koi-science/DI-Lambda-schematics-avr/DI-Lambda-UNO/DI-Lambda-UNO-panel-LED/DI-Lambda-UNO-panel-LED.kicad_pcb

## KiCad design DI-Lambda-UNO/DI-Lambda-UNO-panel-LED/DI-Lambda-UNO-panel-LED.kicad_pcb (2019-07-14)

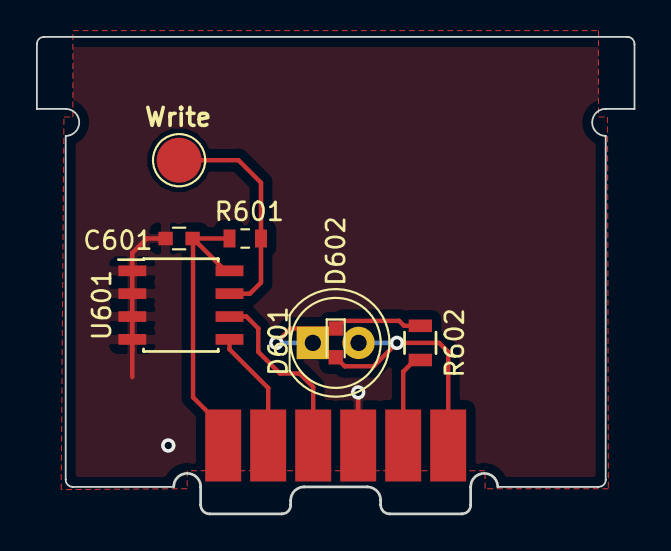
[picture p1: board DI-Lambda-UNO-panel-LED.kicad_pcb from above]

Board: 2 copper layers, 33.2 x 26.5 mm, 9 parts (0 on the bottom side), 8 nets.

Parts:
C601: 0.1uF 25v; C_0603
D601: LED; LED_D5.0mm
D602: LED; LED_0603
J601: Conn_01X06; Contact-2.5x6
MK601: Mounting_Hole; Tab_LED
R601: 4.75K; R_0603_1608Metric
R602: 470R; R_0805
U601: 24LC02; SOIC-8_3.9x4.9mm_Pitch1.27mm
W601: WRITE; TestPoint_Pad_D2.5mm

Connections:
/GLED: J601.5, R602.1
/SCL: J601.3, U601.6
/SDA: J601.2, U601.5
/VCC: C601.1, J601.1, R601.1, U601.8
/VLED: D601.2, D602.2, J601.6
GND: C601.2, J601.4, U601.1, U601.2, U601.3, U601.4
unnamed: D601.1, D602.1, R602.2
unnamed: R601.2, U601.7, W601.1
