koi-science/DI-Lambda-schematics-avr/DI-Lambda-UNO/DI-Lambda-UNO-bottom/DI-Lambda-UNO-bottom.kicad_pcb

## KiCad design DI-Lambda-UNO/DI-Lambda-UNO-bottom/DI-Lambda-UNO-bottom.kicad_pcb (2019-07-14)

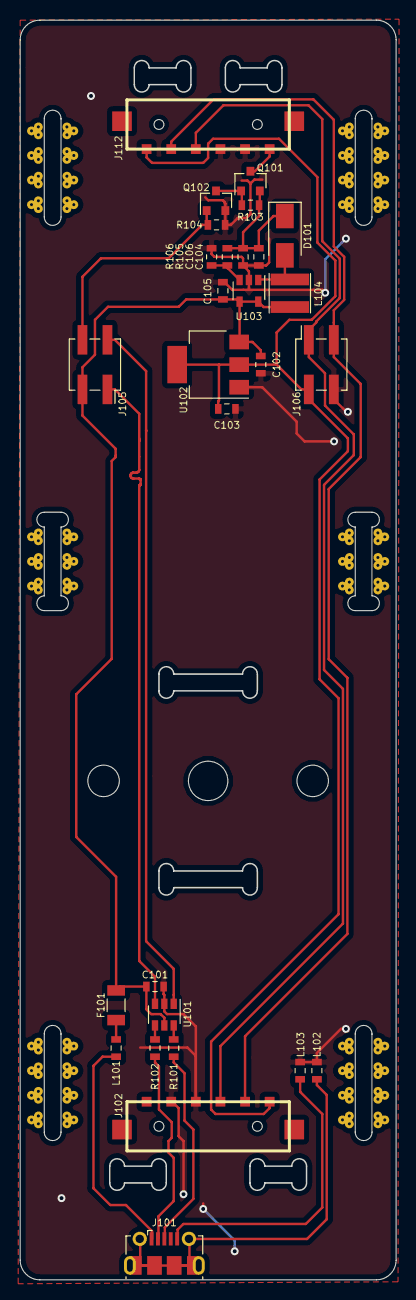
[picture p2: board DI-Lambda-UNO-bottom.kicad_pcb from above]

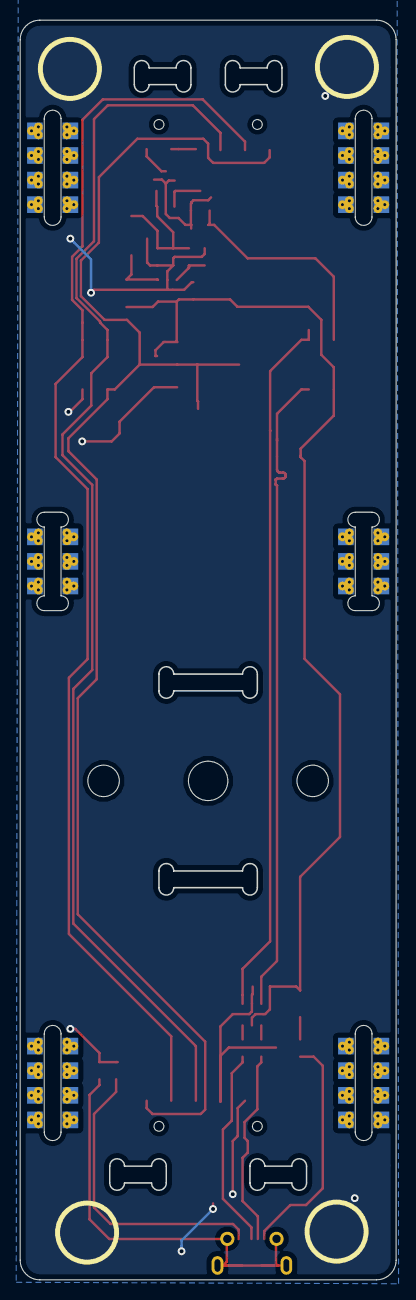
[picture p3: board DI-Lambda-UNO-bottom.kicad_pcb from below]

Board: 2 copper layers, 38.2 x 128.0 mm, 39 parts (6 on the bottom side), 21 nets.

Parts:
C101, C102, C103, C105: 4.7uF 6.3v; C_0603_1608Metric
C104, C106: 1uF 16v; C_0603_1608Metric
D101: SS14; D_SMA
F101: 0.2A; Fuse_1206_3216Metric
J101: USB_OTG; USB_Micro-B_Molex-105017-0001
J102, J112: CONN_01X06; Spring-contact-connector-2.5x6
J103, J104, J110, J111: Conn_02x04_Odd_Even; Pocket_1.6mm_10mm_no_cap_8pads_short_vias
J105, J106: Conn_02x02_Odd_Even; PinSocket_2x02_P2.54mm_Vertical_SMD
J107: Conn_01x01; Cuvette-holder
J108, J109: Conn_02x03_Odd_Even; Pocket_1.6mm_10mm_2cap_6pads_short_vias
L101, L102, L103: FB; L_0603_1608Metric
L104: 6.8uH; L_Taiyo-Yuden_NR-40xx
MK101: Mounting_Hole; Slot_LED
MK102, MK103: Mounting_Hole; Slot_pinhole
MK104: Mounting_Hole; Slot_sensor
Q101: AO3401; SOT-23
Q102: AO3400; SOT-23
R101, R102: 22R; R_0603_1608Metric
R103, R104, R106: 4.75k; R_0603_1608Metric
R105: 42.2k; R_0603_1608Metric
U101: USBLC6-2SC6; SOT-23-6
U102: 3.3v LDO; SOT-223-3_TabPin2
U103: AP3015; SOT-23-5

Connections:
/12v: C104.1, C106.1, D101.1, Q101.2, R103.1, R105.1
/DI_N: J101.2, R102.2
/DI_P: J101.3, R101.2
/D_N: J105.1, U101.3
/D_P: J105.2, U101.1
/LED_PWM: J105.4, Q102.1, R104.1
/SCL: J102.3, J106.1, J112.3
/SDA: J102.2, J106.3, J112.2
/SW: D101.2, L104.1, U103.1
/VBUS: C101.1, C102.2, C105.2, F101.1, J105.3, L104.2, U101.5, U102.3, U103.4, U103.5
/VCC: C103.2, J102.1, J106.2, J112.1, U102.2
/VLED: J112.6, Q101.3
/_D_N: R102.1, U101.4
/_D_P: R101.1, U101.6
GND: C101.2, C102.1, C103.1, C104.2, C105.1, C106.2, J102.4, J102.5, J106.4, J112.4, J112.5, L102.2, L103.2, Q102.2, R104.2, R106.2, U101.2, U102.1, U103.2
unnamed: F101.2, L101.1
unnamed: J101.1, L101.2
unnamed: J101.5, L103.1
unnamed: J101.6, L102.1
unnamed: Q101.1, Q102.3, R103.2
unnamed: R105.2, R106.1, U103.3
