koi-science/DI-Lambda-schematics-avr/DI-Lambda-UNO/DI-Lambda-UNO-panel-Photodiode/DI-Lambda-UNO-panel-Photodiode.kicad_pcb

## KiCad design DI-Lambda-UNO/DI-Lambda-UNO-panel-Photodiode/DI-Lambda-UNO-panel-Photodiode.kicad_pcb (2019-07-14)

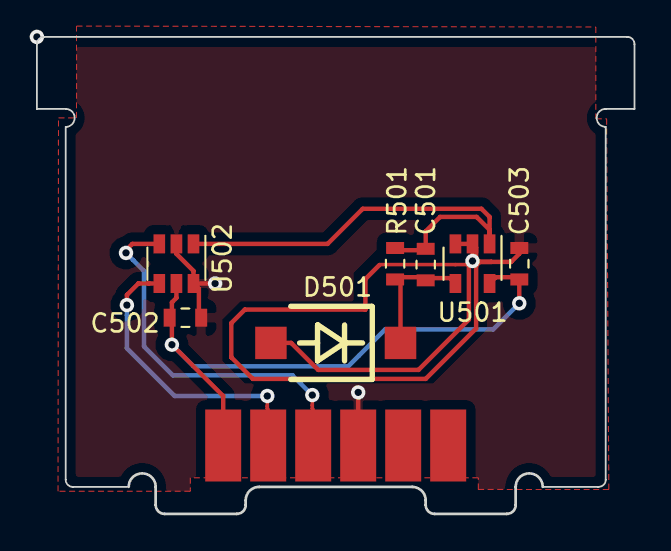
[picture p4: board DI-Lambda-UNO-panel-Photodiode.kicad_pcb from above]

Board: 2 copper layers, 33.2 x 26.5 mm, 9 parts (0 on the bottom side), 6 nets.

Parts:
C501: 10pf; C_0603_1608Metric
C502, C503: 0.1uF 25v; C_0603_1608Metric
D501: D_Photo; 2-SMD-Everlight-Photodiode
J501: Conn_01X06; Contact-2.5x6
MK501: Mounting_Hole; Tab_SENSOR
R501: 1M; R_0603_1608Metric
U501: TP1271; SOT-23-5
U502: MCP3421A0T-E/CH; SOT-23-6

Connections:
/SCL: J501.3, U502.3
/SDA: J501.2, U502.4
/VCC: C502.1, C503.1, J501.1, U501.5, U502.5
GND: C502.2, C503.2, D501.2, J501.4, U501.2, U501.3, U502.2, U502.6
unnamed: C501.1, R501.1, U501.1, U502.1
unnamed: C501.2, D501.1, R501.2, U501.4
