koi-science/DI-Lambda-schematics-avr/DI-Lambda-UNO/DI-Lambda-UNO-top/DI-Lambda-UNO-top.kicad_pcb

## KiCad design DI-Lambda-UNO/DI-Lambda-UNO-top/DI-Lambda-UNO-top.kicad_pcb (2019-07-14)

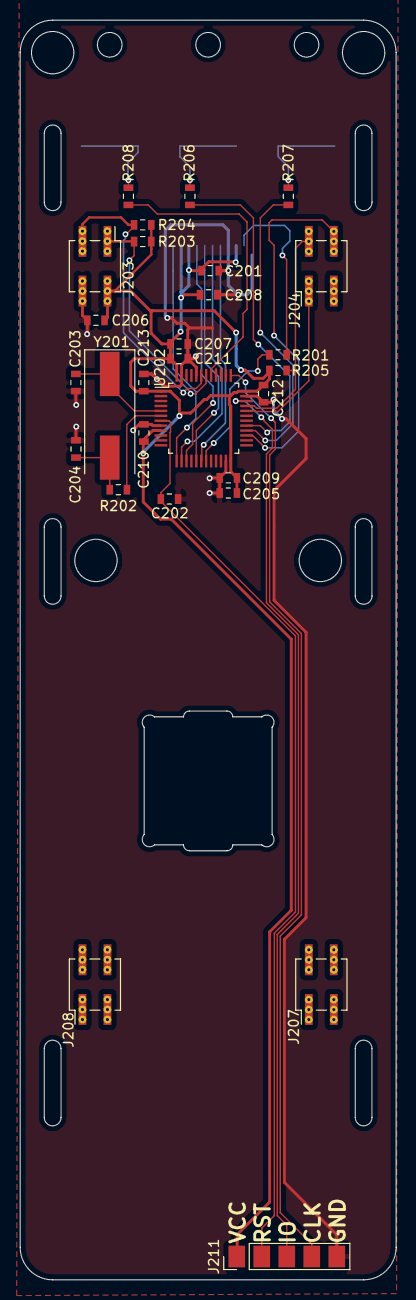
[picture p5: board DI-Lambda-UNO-top.kicad_pcb from above]

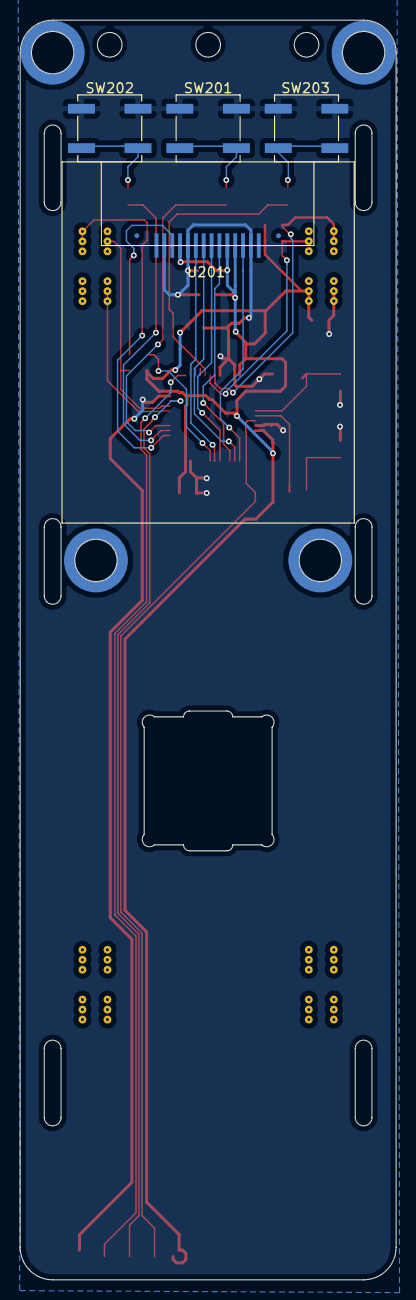
[picture p6: board DI-Lambda-UNO-top.kicad_pcb from below]

Board: 2 copper layers, 38.2 x 128.0 mm, 44 parts (14 on the bottom side), 26 nets.

Parts:
C201, C205, C206, C207: 4.7uF 6.3v; C_0603_1608Metric
C202, C208, C209, C210, C211, C212, C213: 0.1uF 25v; C_0603_1608Metric
C203, C204: 10pF 25V; C_0603_1608Metric
J201, J202, J209, J210: Conn_02x04_Odd_Even; Pocket_1.6mm_7mm_no_cap
J203, J204, J207, J208: Conn_02x02_Odd_Even; PinHeader_2x02_P2.54mm_Vertical_SMD_vias
J205, J206: Conn_02x03_Odd_Even; Pocket_1.6mm_7mm_no_cap
J211: Conn_01x05; Testpoint_1x05_P2.54mm_mixed
MK201: Mounting_Hole; Button_mounts_x3
MK202, MK203, MK204, MK205: Mounting_Hole; Mounting-Hole-SMT-nut-M3-4.3mm
MK206: Mounting_Hole; Cuvette-cutout-top
R201: 220R; R_0603_1608Metric
R202: 390R; R_0603_1608Metric
R203, R204: 4.75K; R_0603_1608Metric
R205, R206, R207, R208: 1.5K; R_0603_1608Metric
SW201: SW_SAMPLE; SW_SPST_B3SL-1002P
SW202: SW_MODE; SW_SPST_B3SL-1002P
SW203: SW_BLANK; SW_SPST_B3SL-1002P
U201: LCD_1.44_ST7735
U202: STM32F103C8Tx; LQFP-48_7x7mm_P0.5mm
Y201: 8Mhz; Crystal_SMD_HC49-SD

Connections:
/BLANK: R208.2, U202.41
/DN: J204.1, U202.32
/DP: J204.2, R205.2, U202.33
/LCD_A0: U201.7, U202.14
/LCD_CS: U201.12, U202.13
/LCD_LED: R201.2, U202.19
/LCD_RST: U201.6, U202.18
/LED_PWM: J204.4, U202.27
/MODE: R207.2, U202.28
/MOSI: U201.8, U202.17
/SAMPLE: R206.2, U202.29
/SCK: U201.9, U202.15
/SCL: J203.1, R203.2, U202.42
/SDA: J203.3, R204.1, U202.43
/SWDCLK: J211.4, U202.37
/SWDIO: J211.3, U202.34
/VCC: C201.2, C205.2, C206.2, C207.2, C208.1, C209.1, C210.1, C211.1, C212.1, C213.1, J203.2, J211.1, R203.1, R204.2, R205.1, U201.4, U201.10, U201.11, U202.1, U202.9, U202.24, U202.36, U202.48
/nRST: C202.1, J211.2, U202.7
GND: C201.1, C202.2, C203.2, C204.2, C205.1, C206.1, C207.1, C208.2, C209.2, C210.2, C211.2, C212.2, C213.2, J203.4, J211.5, SW201.2, SW202.2, SW203.2, U201.2, U201.5, U201.13, U202.8, U202.23, U202.35, U202.44, U202.47
unnamed: C203.1, U202.5, Y201.1
unnamed: C204.1, R202.2, Y201.2
unnamed: R201.1, U201.3
unnamed: R202.1, U202.6
unnamed: R206.1, SW201.1
unnamed: R207.1, SW202.1
unnamed: R208.1, SW203.1
