koi-science/DI-Lambda-schematics-avr/DI-Lambda-UNO/DI-Lambda-UNO-side/DI-Lambda-UNO-side.kicad_pcb

## KiCad design DI-Lambda-UNO/DI-Lambda-UNO-side/DI-Lambda-UNO-side.kicad_pcb (2019-07-14)

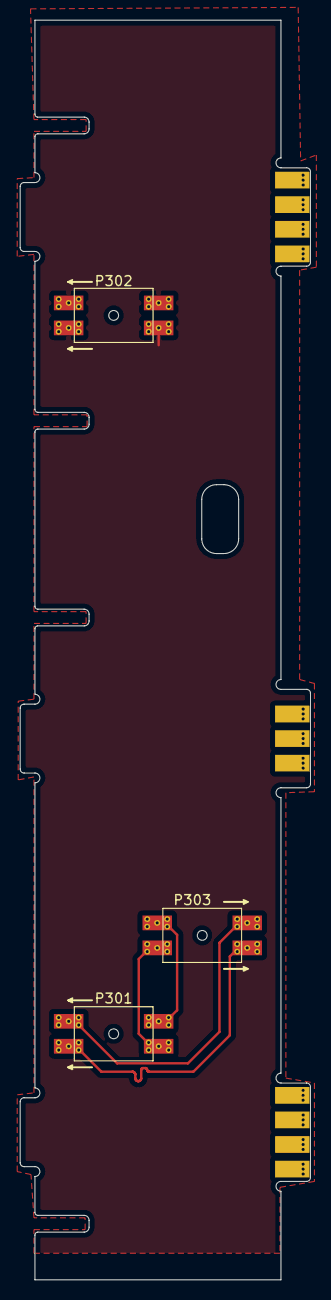
[picture p7: board DI-Lambda-UNO-side.kicad_pcb from above]

Board: 2 copper layers, 29.5 x 128.0 mm, 10 parts (0 on the bottom side), 5 nets.

Parts:
MK301, MK302, MK303: Mounting_Hole; Tab_7mm_1.5mm
MK304: Mounting_Hole; Cuvette_holder_side_hole
P301, P302, P303: CONN_02X02; Female_socket_2.54_2x2p_horizontal_smt
P304, P306: CONN_01X04; Tab_10mm_4pads_vias_3mm
P305: CONN_01X04; Tab_10mm_3pads_vias_3mm

Connections:
/A+: P301.1, P303.3
/A-: P301.3, P303.1
/B+: P301.4, P303.2
/B-: P301.2, P303.4
GND: P302.1, P302.2, P302.3, P302.4
