koi-science/DI-Lambda-schematics-avr/DI-Lambda-UNO/DI-Lambda-UNO-panel-TSL2561/DI-Lambda-UNO-panel-TSL2561.kicad_pcb

## KiCad design DI-Lambda-UNO/DI-Lambda-UNO-panel-TSL2561/DI-Lambda-UNO-panel-TSL2561.kicad_pcb (2017-11-26)

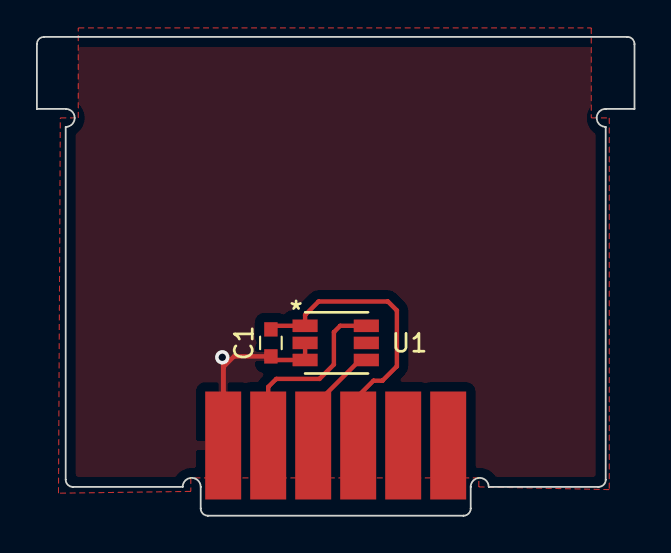
[picture p8: board DI-Lambda-UNO-panel-TSL2561.kicad_pcb from above]

Board: 2 copper layers, 33.2 x 26.6 mm, 3 parts (0 on the bottom side), 4 nets.

Parts:
C1: C_Small; C_0603
J1: Conn_01X06; Contact-2.5x6
U1: TSL2561; TMB-6

Connections:
/SCL: J1.3, U1.4
/SDA: J1.2, U1.6
/VCC: C1.1, J1.4, U1.1
GND: C1.2, J1.1, U1.2, U1.3
