koi-science/DI-Lambda-schematics-avr/DI-Lambda-DITOS/ditos-TSL2561/ditos-TSL2561.kicad_pcb

## KiCad design DI-Lambda-DITOS/ditos-TSL2561/ditos-TSL2561.kicad_pcb (2017-08-27)

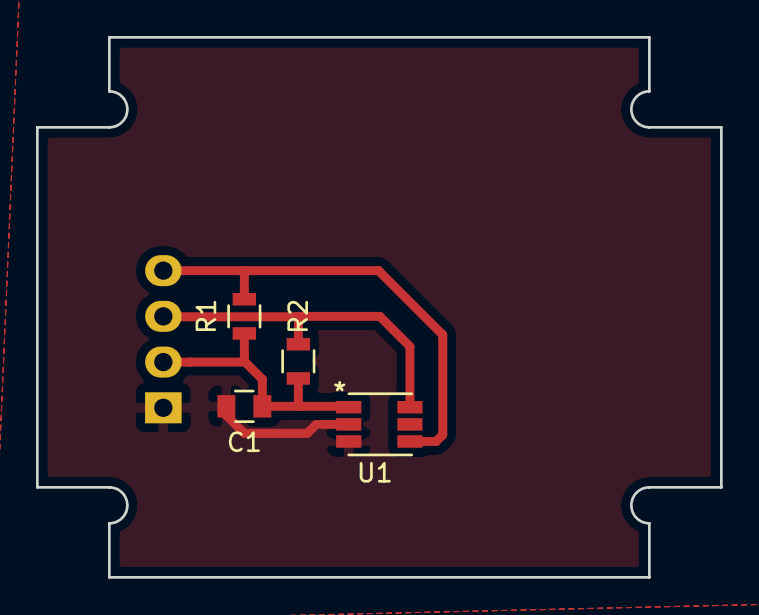
[picture p9: board ditos-TSL2561.kicad_pcb from above]

Board: 2 copper layers, 38.0 x 30.0 mm, 5 parts (1 on the bottom side), 4 nets.

Parts:
C1: 1uF; C_0805
P1: CONN_01X04; Pin_Header_Straight_1x04
R1, R2: 4K7; R_0805
U1: TSL2561; TMB-6

Connections:
GND: C1.1, P1.1, U1.2, U1.3
unnamed: P1.3, R2.1, U1.6
unnamed: P1.4, R1.2, U1.4
VCC: C1.2, P1.2, R1.1, R2.2, U1.1
