koi-science/DI-Lambda-schematics-avr/DI-Lambda-DITOS/DI-Lambda-DITOS-controller/DI-Lambda-DITOS-controller.kicad_pcb

## KiCad design DI-Lambda-DITOS/DI-Lambda-DITOS-controller/DI-Lambda-DITOS-controller.kicad_pcb (2017-08-27)

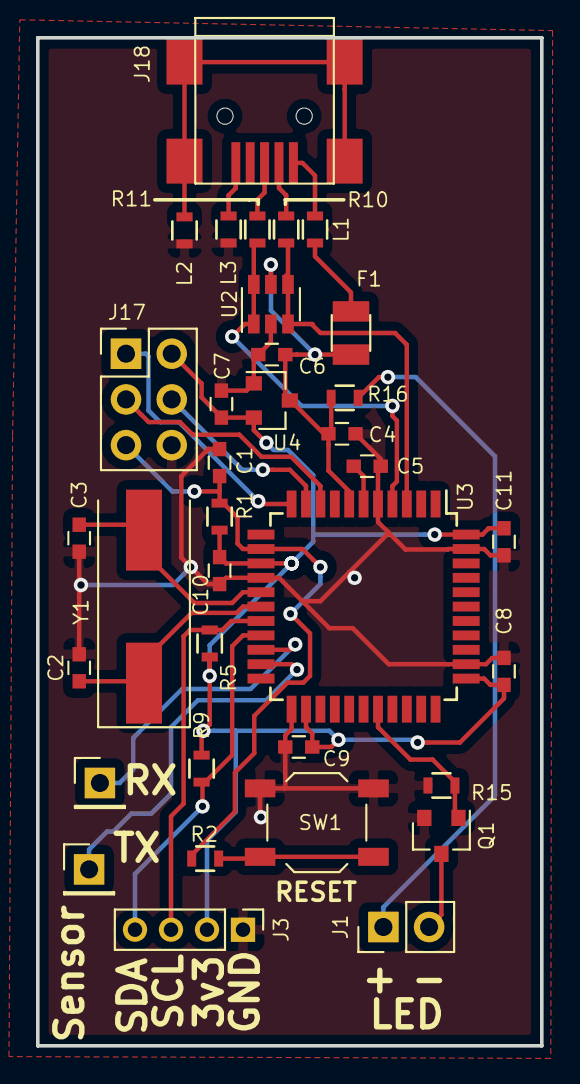
[picture p10: board DI-Lambda-DITOS-controller.kicad_pcb from above]

Board: 2 copper layers, 28.0 x 56.0 mm, 35 parts (0 on the bottom side), 26 nets.

Parts:
C1: 0.1uF; C_0603
C2, C3: 22pF 25V; C_0603
C4: 4.7uF 25V; C_0603
C5: 1uF 25V; C_0603
C6, C7: 4.7uF 25v; C_0603
C8, C9, C10, C11: 0.1uF 25v; C_0603
F1: 0.2A; Fuse_SMD1206_Reflow
J1: Conn_01x02; Pin_Header_Straight_1x02_Pitch2.54mm
J2, J4: Conn_01X01; Pin_Header_Straight_1x01_Pitch2.54mm
J3: Conn_01x04; Pin_Header_Straight_1x04_Pitch2.00mm
J17: CONN_02X03; Pin_Header_Straight_2x03_Pitch2.54mm
J18: USB_OTG; USB_Mini-B
L1, L2, L3: FB; R_0603
Q1: AO3400; SOT-23
R1, R5, R9, R15: 4.7k; R_0603
R2: 330R; R_0603
R10, R11: 22R; R_0603
R16: DNP; R_0603
SW1: RESET; SW_SPST_TL3342
U2: USBLC6-2SC6; SOT-23-6
U3: ATMEGA32U4-MU; TQFP-44_10x10mm_Pitch0.8mm
U4: 3.3v LDO; SOT-23
Y1: 8Mhz; Crystal_SMD_HC49-SD

Connections:
/GLED: J1.2, Q1.3
/LED_PWM: Q1.1, R15.1, U3.29
/MISO: J17.1, U3.11
/MOSI: J17.4, U3.10
/RST: C1.2, J17.5, R1.2, R2.1, U3.13
/RX: J2.1, U3.20
/SCK: J17.3, U3.9
/SCL: J3.3, R5.2, U3.18
/SDA: J3.4, R9.1, U3.19
/TX: J4.1, U3.21
/VBUS: C4.1, C6.2, F1.1, R16.1, U2.5, U3.7, U4.3
/VCC: C7.2, C8.1, C9.1, C10.1, C11.1, J3.2, J17.2, R1.1, R5.1, R9.2, U3.14, U3.24, U3.34, U3.44, U4.2
/VLED: J1.1, R16.2
GND: C1.1, C2.2, C3.2, C4.2, C5.2, C6.1, C7.1, C8.2, C9.2, C10.2, C11.2, J3.1, J17.6, L2.2, L3.2, Q1.2, R15.2, SW1.1, U2.2, U3.5, U3.15, U3.23, U3.35, U3.43, U4.1
unnamed: C2.1, U3.17, Y1.1
unnamed: C3.1, U3.16, Y1.2
unnamed: C5.1, U3.6
unnamed: F1.2, L1.1
unnamed: J18.1, L1.2
unnamed: J18.2, R10.2
unnamed: J18.3, R11.2
unnamed: J18.5, L3.1
unnamed: J18.6, L2.1
unnamed: R2.2, SW1.2
unnamed: R10.1, U2.3, U2.4, U3.3
unnamed: R11.1, U2.1, U2.6, U3.4
