koi-science/DI-Lambda-schematics-avr/DI-Lambda-DITOS/ditos-LED/ditos-LED.kicad_pcb

## KiCad design DI-Lambda-DITOS/ditos-LED/ditos-LED.kicad_pcb (2017-08-27)

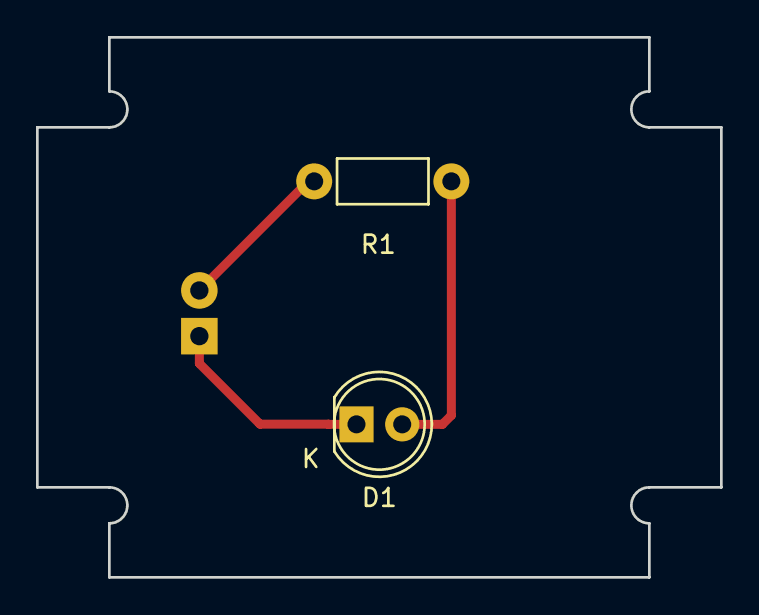
[picture p11: board ditos-LED.kicad_pcb from above]

Board: 2 copper layers, 38.0 x 30.0 mm, 3 parts (1 on the bottom side), 3 nets.

Parts:
D1: LED; LED-5MM
P1: CONN_01X02; Pin_Header_Straight_1x02
R1: R; Resistor_Horizontal_RM7mm

Connections:
unnamed: D1.1, P1.1
unnamed: D1.2, R1.1
unnamed: P1.2, R1.2
