koi-science/DI-Lambda-schematics-avr/(commit log)

2017-08-27 Import DI-Lambda DITOS schematics
    [DI-Lambda-DITOS-controller.kicad_pcb, DI-Lambda-DITOS-controller.sch, ditos-LED.kicad_pcb, ditos-LED.sch, ditos-TSL2561.kicad_pcb, ditos-TSL2561.sch]
2017-08-27 Import DI-Lambda UNO v1.0
    [DI-Lambda-UNO-bottom.kicad_pcb, DI-Lambda-UNO-bottom.sch, DI-Lambda-UNO-insert.kicad_pcb, DI-Lambda-UNO-insert.sch, DI-Lambda-UNO-panel-LED.kicad_pcb, DI-Lambda-UNO-panel-LED.sch, DI-Lambda-UNO-panel-TSL2561.kicad_pcb, DI-Lambda-UNO-panel-TSL2561.sch]
2017-08-27 Fix DI-Lambda DITOS LED module library references
2017-08-27 DI-Lambda UNO bottom cleanup
    [DI-Lambda-UNO-bottom.kicad_pcb, DI-Lambda-UNO-bottom.sch]
2017-08-27 DI-Lambda UNO insert cleanup
    [DI-Lambda-UNO-insert.sch]
2017-08-27 Fix spring contact module name
    [DI-Lambda-UNO-bottom.kicad_pcb, DI-Lambda-UNO-bottom.sch, DI-Lambda-UNO-panel-TSL2561.kicad_pcb, DI-Lambda-UNO-panel-TSL2561.sch]
2017-08-27 DI-Lambda UNO LED module cleanup
    [DI-Lambda-UNO-panel-LED.kicad_pcb, DI-Lambda-UNO-panel-LED.sch]
2017-08-27 DI-Lambda UNO TSL2561 modules cleanup
    [DI-Lambda-UNO-panel-TSL2561.sch]
2017-08-27 DI-Lambda UNO side panel cleanup
    [DI-Lambda-UNO-side.sch]
2017-08-27 DI-Lambda UNO top panel cleanup
    [DI-Lambda-UNO-top.kicad_pcb, DI-Lambda-UNO-top.sch]
2017-10-23 Use longer contact pas for the spring connector
    [DI-Lambda-UNO-panel-LED.kicad_pcb, DI-Lambda-UNO-panel-TSL2561.kicad_pcb]
2017-10-23 Remove notches from the LED/Sensor/Pinhole panels
    [DI-Lambda-UNO-panel-LED.kicad_pcb, DI-Lambda-UNO-panel-TSL2561.kicad_pcb, DI-Lambda-UNO-panel-pinhole.kicad_pcb]
2017-10-23 Swap SDA/SCL on the main board
    [DI-Lambda-UNO-bottom.kicad_pcb, DI-Lambda-UNO-bottom.sch]
2017-10-23 Connect UCAP to VCC on the main board
    [DI-Lambda-UNO-bottom.kicad_pcb, DI-Lambda-UNO-bottom.sch]
2017-10-23 Increase cuvette holder hole size to 13mm
    [DI-Lambda-UNO-insert.kicad_pcb]
2017-10-23 Increase top plate cuvette hole size to 13mm
    [DI-Lambda-UNO-top.kicad_pcb]
2017-10-23 Update the SMT receptacle footprint - holes are 1.8mm
    [DI-Lambda-UNO-bottom.kicad_pcb, DI-Lambda-UNO-top.kicad_pcb]
2017-10-23 Remove connectors and notches from the side panels
    [DI-Lambda-UNO-side.kicad_pcb, DI-Lambda-UNO-side.sch]
2017-10-23 Update side panel dimensions for v1.1
    [DI-Lambda-UNO-side.kicad_pcb]
2017-10-23 Rework the top plate - STM+THT connectors and new dimensions
    [DI-Lambda-UNO-top.kicad_pcb, DI-Lambda-UNO-top.sch]
2017-10-23 Update connectors on the bottom plate
    [DI-Lambda-UNO-bottom.kicad_pcb, DI-Lambda-UNO-bottom.sch]
2017-10-23 Fix pinhole plate tab size, 13mm
    [DI-Lambda-UNO-panel-pinhole.kicad_pcb]
2017-10-23 Move spring connectors 0.3mm back on the bottom plate
    [DI-Lambda-UNO-bottom.kicad_pcb]
2017-10-23 Fix up the routing after connector update on the bottom plate
    [DI-Lambda-UNO-bottom.kicad_pcb]
2017-10-23 Update main plate dimensions
    [DI-Lambda-UNO-bottom.kicad_pcb]
2017-10-23 Use SMT pin header for ISP on the bottom plate
    [DI-Lambda-UNO-bottom.kicad_pcb, DI-Lambda-UNO-bottom.sch]
2017-10-23 Pour copper everywhere on the main plate
    [DI-Lambda-UNO-bottom.kicad_pcb]
2017-10-23 Clean up routing, a bit shielding behind the crystal on bottom plate
    [DI-Lambda-UNO-bottom.kicad_pcb]
2017-10-23 Clean up silkscreen, use SMT pads for RX/TX on the main plate
    [DI-Lambda-UNO-bottom.kicad_pcb]
2017-10-23 Use Micro-USB instead on Mini on the bottom plate
    [DI-Lambda-UNO-bottom.kicad_pcb, DI-Lambda-UNO-bottom.sch]
2017-10-25 Change pinhole tab length to 15mm
    [DI-Lambda-UNO-bottom.kicad_pcb, DI-Lambda-UNO-panel-pinhole.kicad_pcb]
2017-10-25 Copper pour on the LED board
    [DI-Lambda-UNO-panel-LED.kicad_pcb]
2017-10-25 Copper pour and slight dimension adjusements on the TSL5261 board
    [DI-Lambda-UNO-panel-TSL2561.kicad_pcb]
2017-10-25 Copper pour on the side boards
    [DI-Lambda-UNO-side.kicad_pcb]
2017-10-25 Adjust connctors on the cuvette holder
    [DI-Lambda-UNO-insert.kicad_pcb, DI-Lambda-UNO-insert.sch]
2017-11-02 Fill in a few component names on the bottom board
    [DI-Lambda-UNO-bottom.sch]
2017-11-02 Fix up connector footprints on the cuvette holder board
    [DI-Lambda-UNO-insert.sch]
2017-11-26 Adjust copper pour on multiple boards
    [DI-Lambda-UNO-panel-LED.kicad_pcb, DI-Lambda-UNO-panel-TSL2561.kicad_pcb, DI-Lambda-UNO-panel-pinhole.kicad_pcb, DI-Lambda-UNO-side.kicad_pcb]
2017-12-02 Add a photodiode-based sensor board
    [DI-Lambda-UNO-panel-Photodiode.kicad_pcb, DI-Lambda-UNO-panel-Photodiode.sch]
2017-12-05 Photodiode board: Fix the op amp pinout
    [DI-Lambda-UNO-panel-Photodiode.kicad_pcb, DI-Lambda-UNO-panel-Photodiode.sch]
2017-12-05 Photodiode board: Add missing libs and footprints
2017-12-05 Photodiode board: Convert to 18mm height
    [DI-Lambda-UNO-panel-Photodiode.kicad_pcb]
2017-12-05 Pinhole board: Convert to 18mm height
    [DI-Lambda-UNO-panel-pinhole.kicad_pcb]
2017-12-08 LED board: convert to 18mm height
    [DI-Lambda-UNO-panel-LED.kicad_pcb]
2017-12-08 Side board: Convert to 18mm height
    [DI-Lambda-UNO-side.kicad_pcb]
2017-12-14 Add the cuvette holder footprint
2017-12-14 Add the 2x2p horizontal 2.54mm SMT socket footprint
2018-01-02 Update schematics to version 1.3
    [DI-Lambda-UNO-bottom.kicad_pcb, DI-Lambda-UNO-bottom.sch, DI-Lambda-UNO-panel-LED.kicad_pcb, DI-Lambda-UNO-panel-Photodiode.kicad_pcb, DI-Lambda-UNO-panel-Photodiode.sch, DI-Lambda-UNO-side.kicad_pcb, DI-Lambda-UNO-side.sch, DI-Lambda-UNO-top.kicad_pcb]
2018-02-03 Version 1.5 redesign WIP
    [DI-Lambda-UNO-bottom.kicad_pcb, DI-Lambda-UNO-bottom.sch, DI-Lambda-UNO-side.kicad_pcb, DI-Lambda-UNO-side.sch]
2018-03-10 Version 1.5
    [DI-Lambda-UNO-bottom.kicad_pcb, DI-Lambda-UNO-bottom.sch, DI-Lambda-UNO-panel-LED.kicad_pcb, DI-Lambda-UNO-panel-LED.sch, DI-Lambda-UNO-panel-Photodiode.kicad_pcb, DI-Lambda-UNO-panel-Photodiode.sch, DI-Lambda-UNO-panel-pinhole.kicad_pcb, DI-Lambda-UNO-panel-pinhole.sch]
2018-04-01 Version 1.6
    [DI-Lambda-UNO-bottom.kicad_pcb, DI-Lambda-UNO-bottom.sch, DI-Lambda-UNO-panel-LED.kicad_pcb, DI-Lambda-UNO-panel-LED.sch, DI-Lambda-UNO-side.kicad_pcb, DI-Lambda-UNO-side.sch, DI-Lambda-UNO-top-cover.kicad_pcb, DI-Lambda-UNO-top-cover.sch]
2018-04-01 Add missing footprints
2019-07-14 More missing fotprints
    [DI-Lambda-UNO-bottom.kicad_pcb, DI-Lambda-UNO-bottom.sch, DI-Lambda-UNO-panel-LED.kicad_pcb, DI-Lambda-UNO-panel-LED.sch, DI-Lambda-UNO-panel-Photodiode.kicad_pcb, DI-Lambda-UNO-panel-Photodiode.sch, DI-Lambda-UNO-panel-pinhole.kicad_pcb, DI-Lambda-UNO-side.kicad_pcb]
